Aizenrath/material-probe/case/sensor_cap.stl

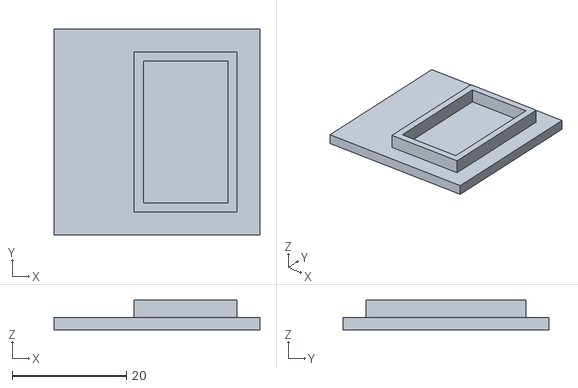
[picture p1: CAD file, 2026-11-07]
case/sensor_cap.stl
36.0 x 36.0 x 5.20
