Aizenrath/material-probe/case/base.stl

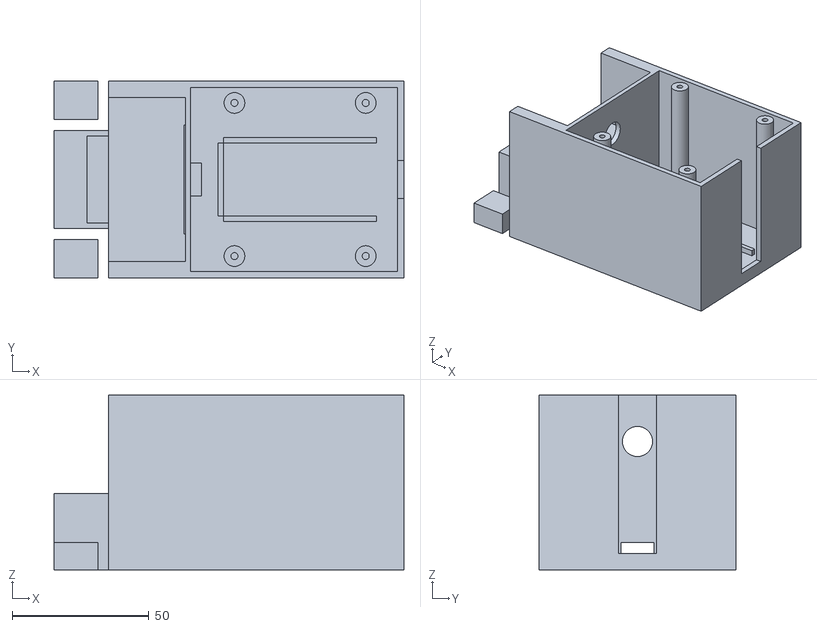
[picture p2: CAD file, 2026-11-07]
case/base.stl
128.0 x 72.0 x 64.0
