Aizenrath/material-probe/case/lid.stl

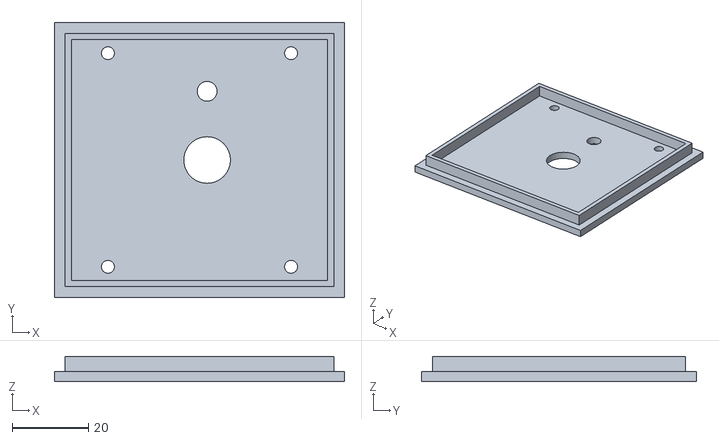
[picture p3: CAD file, 2026-11-07]
case/lid.stl
76.0 x 72.0 x 6.60
