Aizenrath/material-probe/firmware/WallColorCam/config.example.h

#pragma once

// Copy this file to config.h and fill in the network the PC is already on.
// 2.4 GHz only. The ESP32-S3 does not join 5 GHz Wi-Fi.
#define WIFI_SSID "YOUR_WIFI_NAME"
#define WIFI_PASSWORD "YOUR_WIFI_PASSWORD"
